AxxAxx/AxxBeam/images/AxxBeam_alpha.jpg

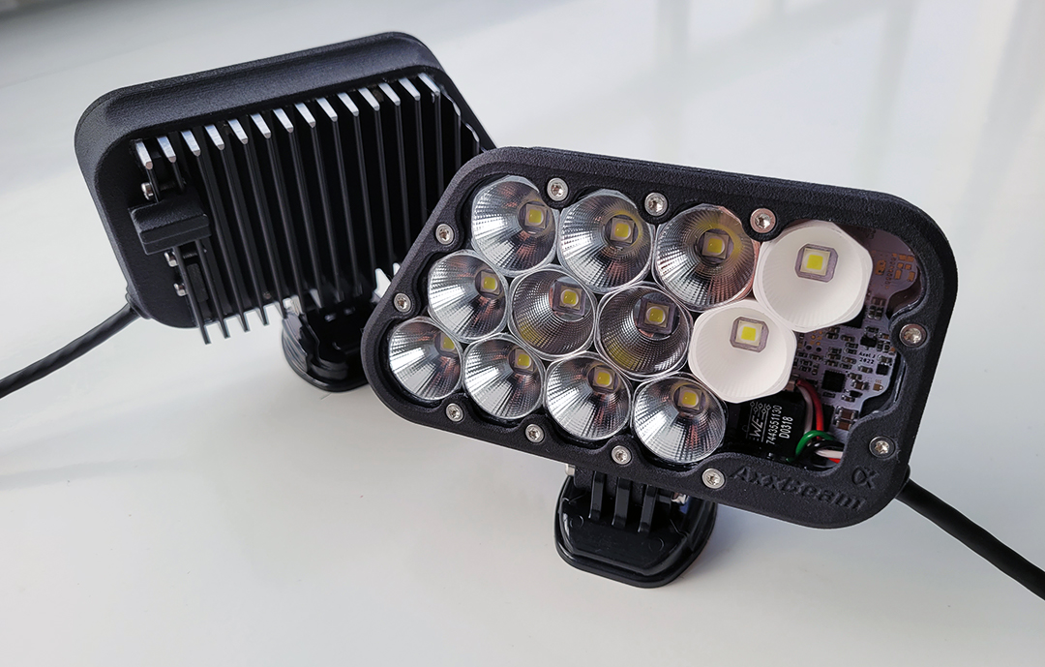
images/AxxBeam_alpha.jpg
