AxxAxx/AxxBeam/images/AxxBeam_alpha_VS_LedX.jpg

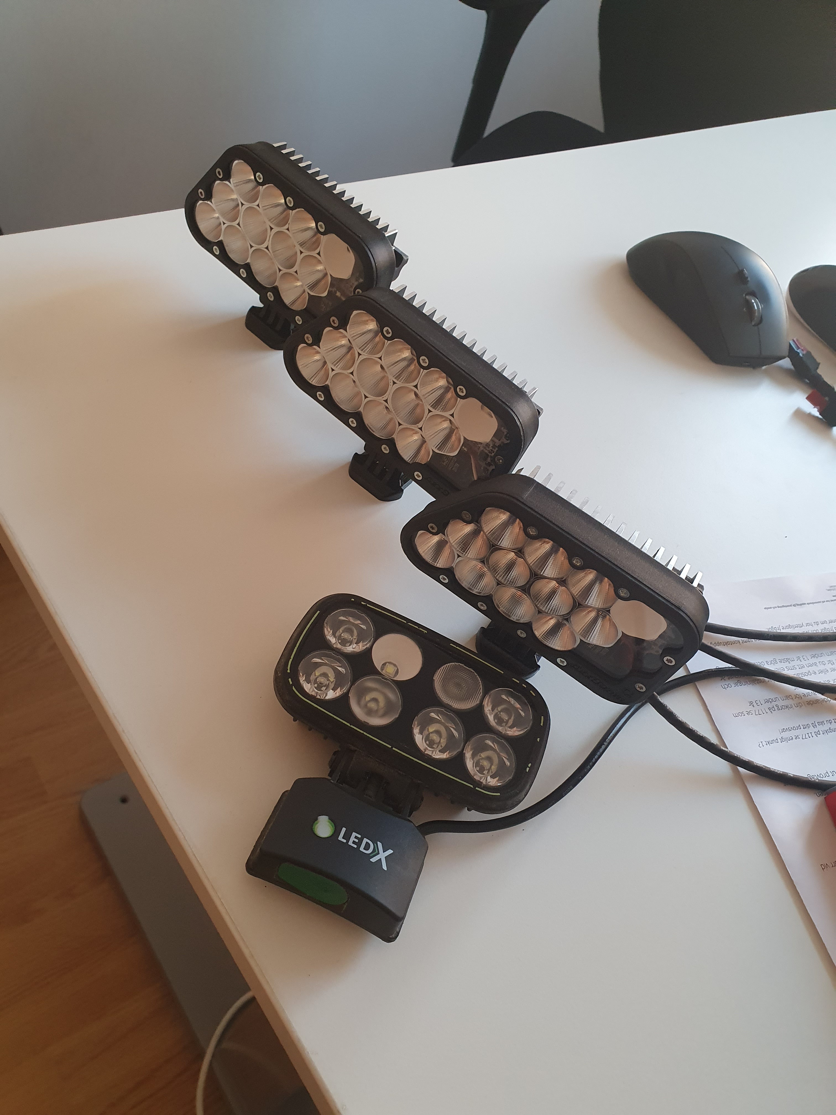
images/AxxBeam_alpha_VS_LedX.jpg
