AxxAxx/AxxBeam/images/AxxBeam_ISO.jpg

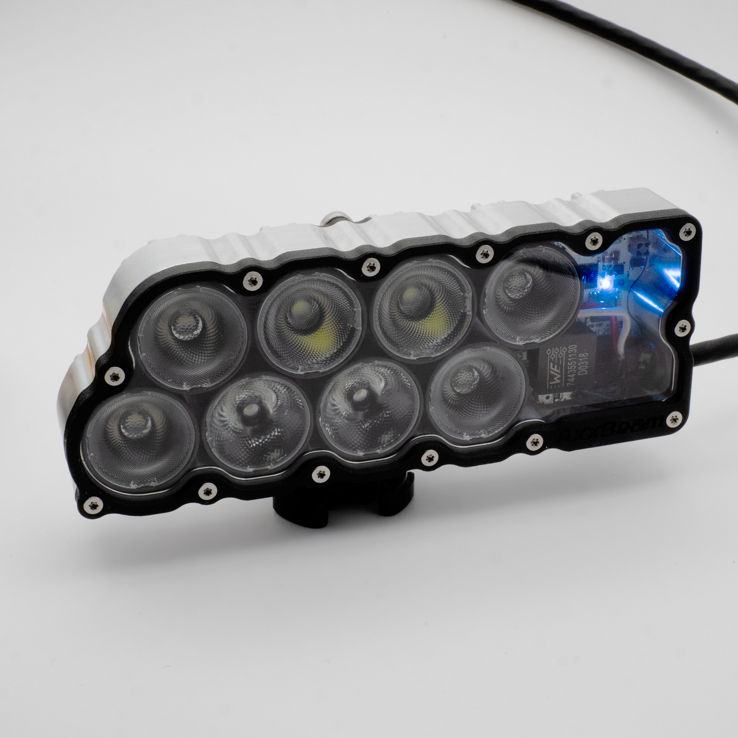
images/AxxBeam_ISO.jpg
