AxxAxx/AxxBeam/images/AxxBeam_on_FE350.jpg

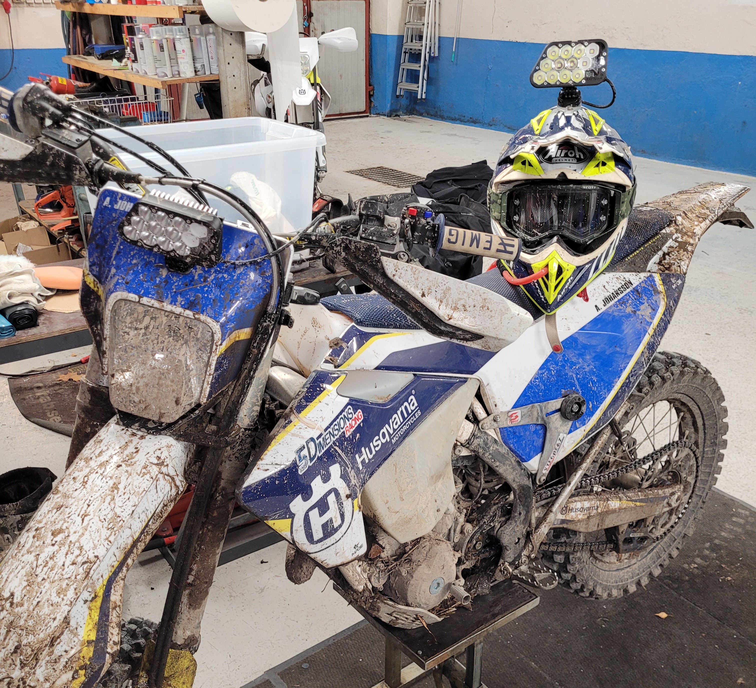
images/AxxBeam_on_FE350.jpg
