AxxAxx/AxxBeam/AxxBeam_firmware/AxxBeam_Software.ioc

Mcu.UserName=STM32G431KBUx
PA0.GPIO_Label=HALLSENSOR
PA0.Signal=ADC1_IN1
PA1.GPIO_Label=V_SENSE
PA1.Signal=ADC1_IN2
PA11.GPIO_Label=BLE_RST
PA11.Signal=GPIO_Output
PA12.GPIO_Label=BLE_MODE
PA12.Signal=GPIO_Output
PA13.Signal=SYS_JTMS-SWDIO
PA14.Signal=SYS_JTCK-SWCLK
PA15.Signal=USART2_RX
PA2.Signal=OPAMP1_VOUT
PA3.GPIO_Label=ENABLE
PA3.Signal=GPIO_Output
PA4.GPIO_Label=BLUE_LED
PA4.Signal=S_TIM3_CH2
PA5.GPIO_Label=RED_LED
PA5.Signal=GPIO_Output
PA8.Signal=I2C2_SDA
PA9.Signal=I2C2_SCL
PB3.Signal=USART2_TX
PB6.Signal=USART1_TX
PB7.Signal=USART1_RX
