AxxAxx/AxxBeam/AxxBeam_firmware/Core/Inc/main.h

#define HALLSENSOR_Pin GPIO_PIN_0
#define HALLSENSOR_GPIO_Port GPIOA
#define V_SENSE_Pin GPIO_PIN_1
#define V_SENSE_GPIO_Port GPIOA
#define ENABLE_Pin GPIO_PIN_3
#define ENABLE_GPIO_Port GPIOA
#define BLUE_LED_Pin GPIO_PIN_4
#define BLUE_LED_GPIO_Port GPIOA
#define RED_LED_Pin GPIO_PIN_5
#define RED_LED_GPIO_Port GPIOA
#define BLE_RST_Pin GPIO_PIN_11
#define BLE_RST_GPIO_Port GPIOA
#define BLE_MODE_Pin GPIO_PIN_12
#define BLE_MODE_GPIO_Port GPIOA
